mkcoffe/ESP32ChromaticGuitarTuner/schematic.pdf

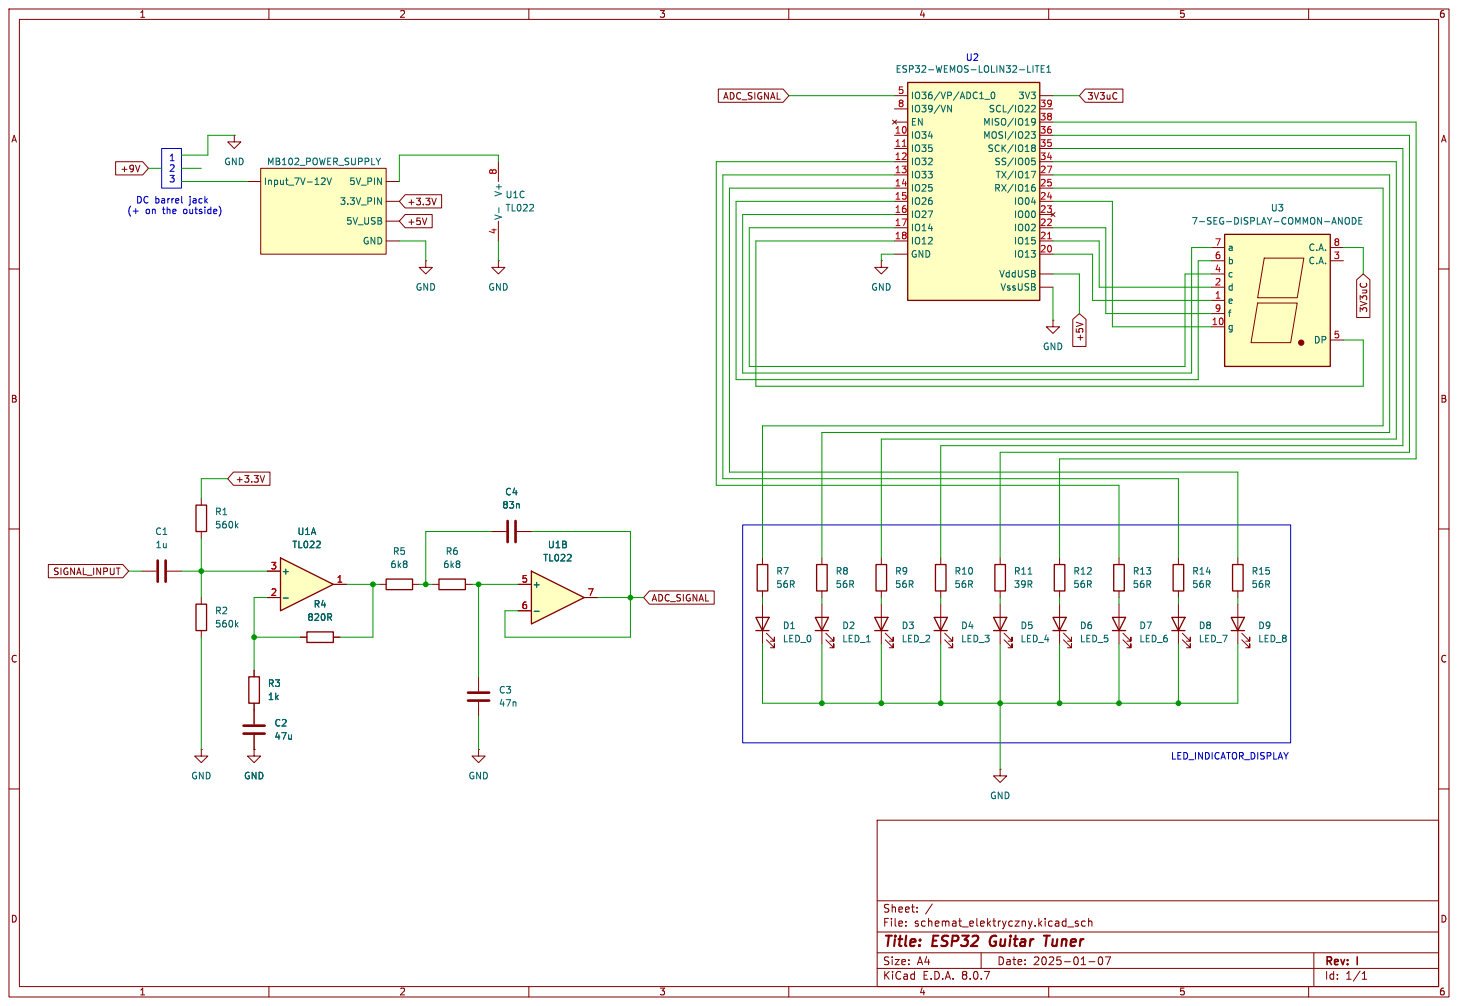
[picture p1: page 1]

Id: 1/1 Title: ESP32 Guitar Tuner File: schemat_elektryczny.kicad_sch Sheet: /
