mkcoffe/ESP32ChromaticGuitarTuner/(commit log)

2024-12-05 Basically everything works and shows notes to tune with a resonable precision. Would need some code to prevent displaying unstable data.
    [Main.ino, guitarTunerDisplay.cpp, guitarTunerDisplay.h]
2025-08-17 Add files via upload
    electronic schematic added
